SyrNitram/Motor_Board/Docs/Diagramme fonctionnement carte moteur.pptx

## Diagramme fonctionnement carte moteur

Contrôle 6-step uniquement

## Slide 2

Séquenceur

Tâche CAN

Tâche POIGNEE

Tâche CONTRÔLE MOTEUR

Commande et type de commande

Trame reçue

Interruption extérieure

Interruption CAN

Interruption HALL

Données poignée

Structure principale

Trame reçue

Données poignée

Données EOS

Commande et type de commande

Etat capteurs Hall

Position

Données EOS

Position (en pas de capteur)

## Tâche POIGNEE

Lecture EOS

Donnée EOS

Lecture ADC

Données brutes

Moyenne glissante

Données poignée filtrées

## Tâche CAN

Données poignées

Trame à envoyer

Génération trame CAN

Emission trame CAN

Trame reçue

Décodage trame CAN

Commande et type de commande

## Tâche CONTRÔLE MOTEUR

- Si contrôle en boucle ouverte :
- Si contrôle en position

Commande PWM

Génération PWM

Commande position

Commande vitesse

PID position

PID vitesse

Commande PWM

Génération PWM

Position

Calcul vitesse

Vitesse
