SyrNitram/Motor_Board/MOTOR_BOARD_V2/modules/Scheduler/static_analysis.pdf

# Statistiques 09.12.2022

Erreurs : 0

Avertissements : 0

Avertissement de style : 1

Portability warnings : 0

Avertissements de performance : 0

Information messages : 0

1
