SyrNitram/Motor_Board/MOTOR_BOARD_V2/modules/platform/Src/static_analysis.pdf

# Statistiques 26.10.2022

Erreurs : 0

Avertissements : 0

Avertissement de style : 5

Portability warnings : 0

Avertissements de performance : 0

Information messages : 0

1
