SyrNitram/Motor_Board/Docs/Recapitulatif des tests.pdf

## Récapitulatif des tests réalisés sur la carte moteur

Les tests ont été réalisés avec le programme de test et non avec le programme des carte moteur complet.

Débugué avec STM32CubeIDE 1.9.0 avec mon ordinateur personnel.

Le débogage ne fonctionnant pas sur STM32CubeIDE de l’ordinateur du bureau, la version est peut-être différente. En revanche le flash fonctionne avec STM32CubeProgrammer.

L’alimentation utilisé est la petite alim de labo HO power PS2122LE réglé. sur le paramètre 12V. La tension est aux alentours de 12.2V.

Le débugueur utilisé est le ST-Link V2 (celui avec le GND entre IO et CLK et également l’autre type).

Il est possible de flasher la carte en l’alimentant uniquement avec le 3V3 du débugueur.

Le moteur utilisé est un moteur roue. Ses capteurs fonctionnent en 3V3 et ont été testé en 3V3 (expliqué plus loin).

## Configuration de horloges

### Test de HAL_Delay()

Génération d’un signal cadencé par HAL_Delay() pour tester sa précision .

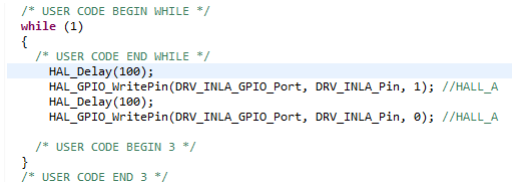
[picture p2: figure]

Période de 200ms :

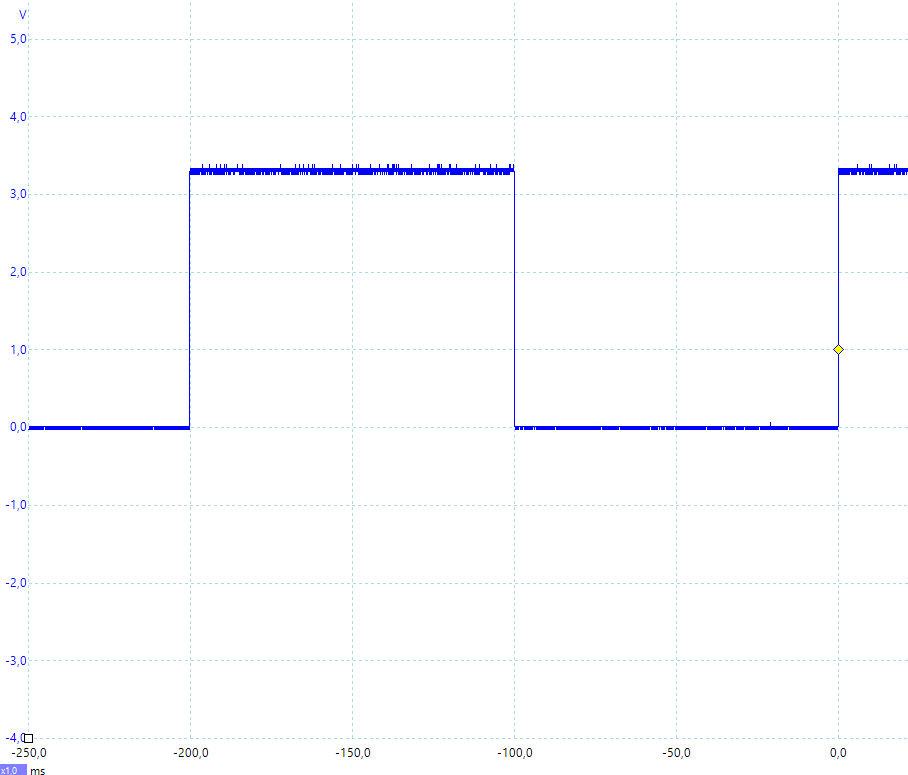
[picture p3: figure]

La fonction HAL DeLay() fonctionne correctement

### Test de la PWM TIM1_CH1

Configuration :
Prescaler = 0 | ARR = 599 | Plage de rapport cyclique : 0 =< ALPHA <= 599

Ici on règle la période et non le registre directement donc il faut écrire 600 et non 599.

Details :
F_timer1 = 48MHZ

On veut une fréquence d’au moins 20 kHz pour être inaudible.

On choisit F_pwm = 40kHz pour être sure.

PWM en mode centrée donc la fréquence de PWM est divisée par 2.

2* F_pwm = F_timer1/ ((prescaler+1) * (ARR+1))

((prescaler+1) * (ARR+1) ) = F_timer1 /2* F_pwm = 48 000/ 80 = 600

On laisse prescaler à 0 pour avoir le plus de valeur de comptage dans un période de PWM (meilleur résolution).

PSC = 0

ARR = 600 – 1 = 599

Test
Test avec un rapport cyclique de 80% pour différencier chaque coté de la PWM et vérifier que le rapport cyclique correspond bien au temps à l’état haut et non l’inverse.

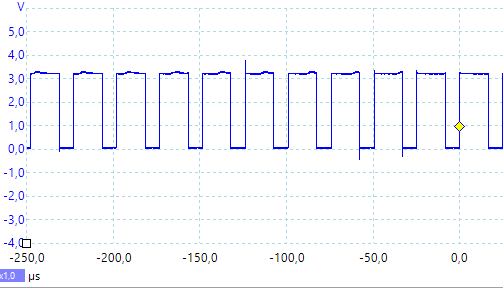
[picture p4: figure]

On trouve une fréquence légèrement supérieure à 40kHz mais le rapport cyclique est bien dans le bon sens.

L’horloge interne est à 48.4MHZ d’après la mesure précédente (ou l’erreur vient du picoscope)

On trouve donc qu’il faut une période de 605 pour être à 40kHz

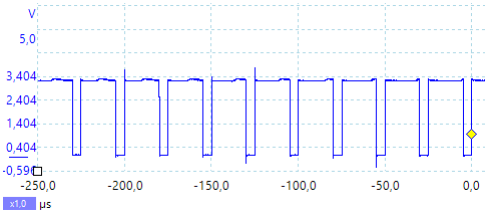
[picture p5: figure]

On trouve quasiment 40kHz, la précision est de 20ns ce qui est satisfaisant.

Valeurs finales : Période = 605 | prescaler = 1 | 0 <= ALPHA <= 605

## Test du DRV8353

### Test du SPI

La configuration du driver se passe sans problème et les lectures de ses registres indiques qu’ils ont tous été configurés correctement.

### Test de la sortie du drv par rapport à l’entrée

Aucun moteur n’est branché lors de ces tests.

Il s’agit de vérifier que la table de vérité suivante est respectée.

Enable et nBrake sont à l’état haut : driver activé et frein désenclenché.

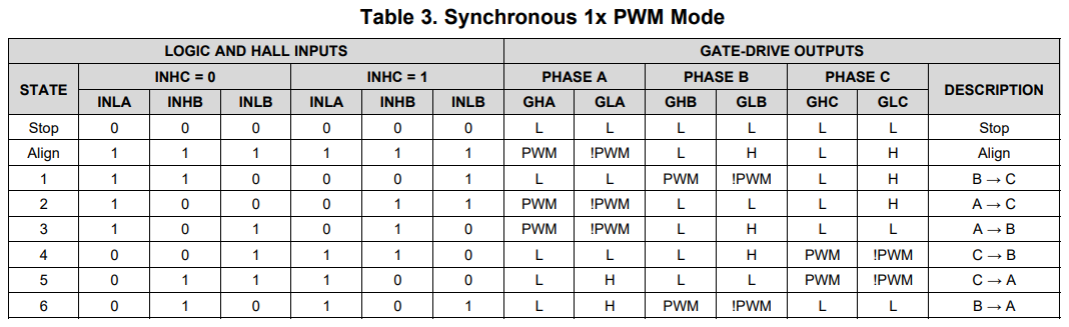
[picture p6: figure]

Etat stop
Les signaux GHx sont à 12V ce qui est égal à la tension dans les phases (donc aux sources), les mosfets sont bien fermés.

Les GLx sont à 0V ce qui correspond également à la tension des sources les mosfets sont bien à l’état bas.

->OK

Etat align
PWM sur A et 0V sur B et C

-> OK

Etat de fonctionnement
Etat | DIR = 0 | DIR = 1
1 | OK | OK
2 | OK | OK
3 | OK | OK
4 | OK | OK
5 | OK | OK
6 | OK | OK
-> OK

La tension dans les phases en hautes impédances est de 12V environ car aucun moteur n’est branché

### Test des temps morts entre les allumages des MOSFETs

Courbe de la doc

GHA en bleu, GLA en vert

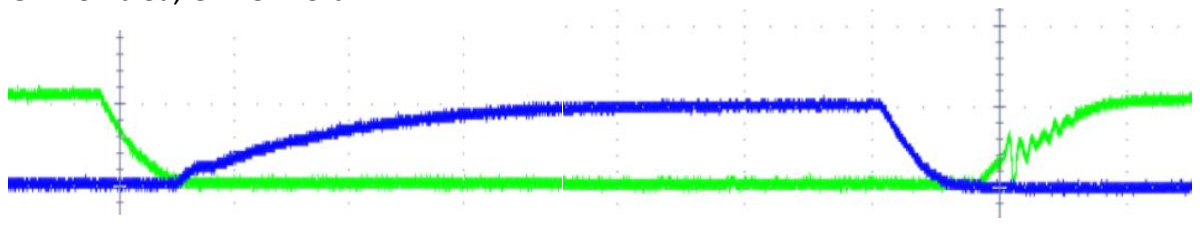
[picture p7: figure]

Courbe mesuré

GHA en bleu, GLA en rouge

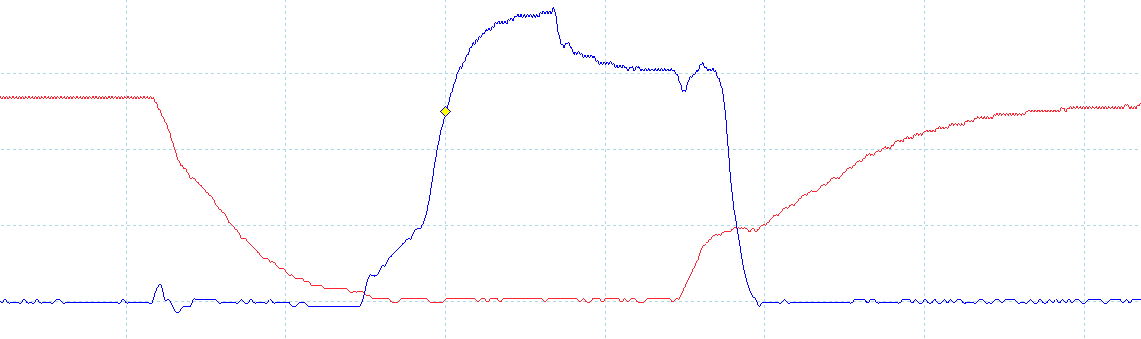
[picture p8: figure]

La monté ressemble bien à celle de la doc, mais la redescente de GHA semble en retard.

Aucun moteur n’est branché aux phases, donc la tension de GHA correspondant à son état bas n’est pas 0V mais plutôt aux alentours de 12V (tension de son drain). Cette tension est atteinte pendant le plateau avant la redescente. C’est donc à ce moment que GHA redescend, la deuxième chute de tension est liée à la chute de tension dans la phase et GHA = Vphase pour être à l’état bloquant.

Maintenant qu’on est sûre que les mosfet n’entre pas en court-circuit on peut tester avec un moteur.

Avec un moteur :

GHA en rouge, GLA en bleu

PWM = 3% | PWM = 4%

La tension

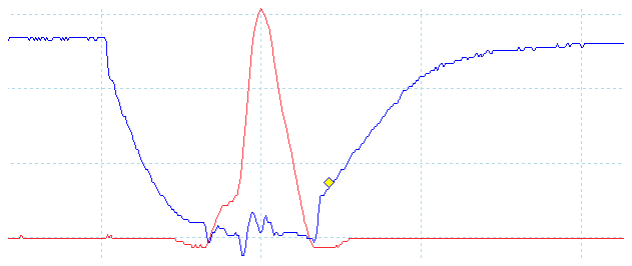
[picture p9: figure]
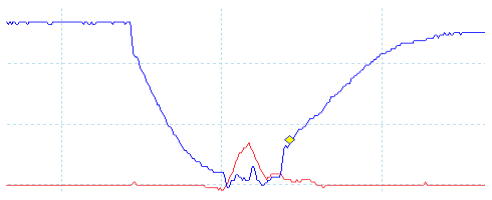
[picture p10: figure]

dans GHA redescend bien avant que GLA remonte.

## Test des capteurs moteurs

Les tests sont réalisés avec un moteur roue pour pouvoir également tester les encodeurs.

### Branchement des effets hall du moteur

Au branchement des capteurs à effet hall la tension 3v3 chute à 2.54V et La tension 5V chute à 4.2V.

Soit le moteur à un défaut, soit les capteurs tirent plus de courant que prévue et le régulateur 5V ne peut pas envoyer assez de courant. Soit l’alimentation de la carte en 12V n’est pas suffisant.

Le courant entrant dans le fils 5V de la prise HALL est d’environ 27mA.

Le régulateur 5V peut normalement fournir jusqu’à 200mA.

En branchant l’alimentation de capteur sur le 3V3 au lieu du 5V, le courant est de 17mA.

Alimenté par le générateur, sans la carte moteur, la consommation est identique.

Pour le moteur roue l’alimentation 3v3 suffit donc elle est utilisée pour les tests.

### Interruption EXTI

Les interruptions fonctionnent sur les encoder et les effets halls.

A chaque interruption sur les capteurs à effets halls, les valeurs des sorties driver sont mises à jour toutes les 3 pour correspondre aux valeurs des capteurs à effets halls du moteur.

## Test du moteur en open-Loop

### Basse vitesse (PWM < 10%)

Le premier test effectué consiste à appliquer une PWM faible et faire correspondre les halls du driver aux hall du moteur. Le moteur ne tourne pas et tremble.

Les tests avec des PWM plus important (toujours sous 10%) ne change rien.

Donc probablement un problème avec l’ordre des capteurs halls.

Après essaie des 6 combinaisons possibles, la bonne solution et de mettre le capteur C sur la sortie A et inversement.

Contrairement à ce que l’on pensait les correspondances ne sont pas :

U -> A | | U -> B
V -> B | mais | V -> A
W -> C | | W -> C

Il faut se fier à la couleur des câbles, la couleur de la phase correspond à la couleur du hall.

Après correction dans le programme le moteur tourne assez fluidement.

### Vitesse plus haute (10% < PWM)

Le banc de test ne permet pas de maintenir fermement le moteur donc l’augmentation de la vitesse sera faite petit a petit afin de prévenir les accidents.

Le moteur tourne sans à-coup et plutôt silencieusement même à 100%.

## Problèmes rencontrés

### Fréquence d’horloge microcontrôleur

L’horloge utilisée est l’horloge interne à 48 MHz. D’après les tests elle n’est pas exactement de 48MHz mais légèrement supérieur. Il faut vérifier s’il s’agit d’une imprécision du pico scope, ou d’une imprécision du micro. Si cela vient du micro il faut voir si c’est la même erreur sur tous les micros, ou s’il y en a un différente à chaque fois. Puis savoir si c’est de fabrication ou à cause des tests avec la mauvaise tension aux débuts. Et enfin savoir si c’est vraiment grave ou non. Savoir s’il faut la remplacer par une autre horloge interne (PLL) et si elle sera plus précise ou non.

### Alimentation capteurs Halls

Le branchement des capteurs moteur sur la carte fait chuter la tension 5V et 3V3.

Cela peut être dû à un problème dans la schématique ou, plus probable, le 5V a besoin de beaucoup de courant en entré pour sortir les 30mA demandé par le moteur (en théorie il faut ~50mA en entré).

Ce qui est surprenant c’est qu’il peut sortir 30mA sans problème pour alimenter directement les capteurs en 3V3 pas 50mA pour les alimenter en 5V. vu la faible différence, la chute de tension ne devrait pas être aussi grande.

### Branchement capteurs Halls

Il ne faut pas se fier aux noms des signaux de la doc pour connaitre l’ordre de branchement des Halls mais à la correspondance de couleur entre le fil du capteur Hall et le fil de la phase correspondante.

Ceci est vrai pour le moteur testé, il faut vérifier si c’est toujours le cas et vérifier également si les couleurs sont branchées au même pin de la prise d’un moteur à l’autre.
